jcasallasv/Sistema-de-reconocimiento-de-gestos/DOCUMENTACIÓN/Primera_etapa_Monitoreo_Ambiental/proyecto1embebidos.png

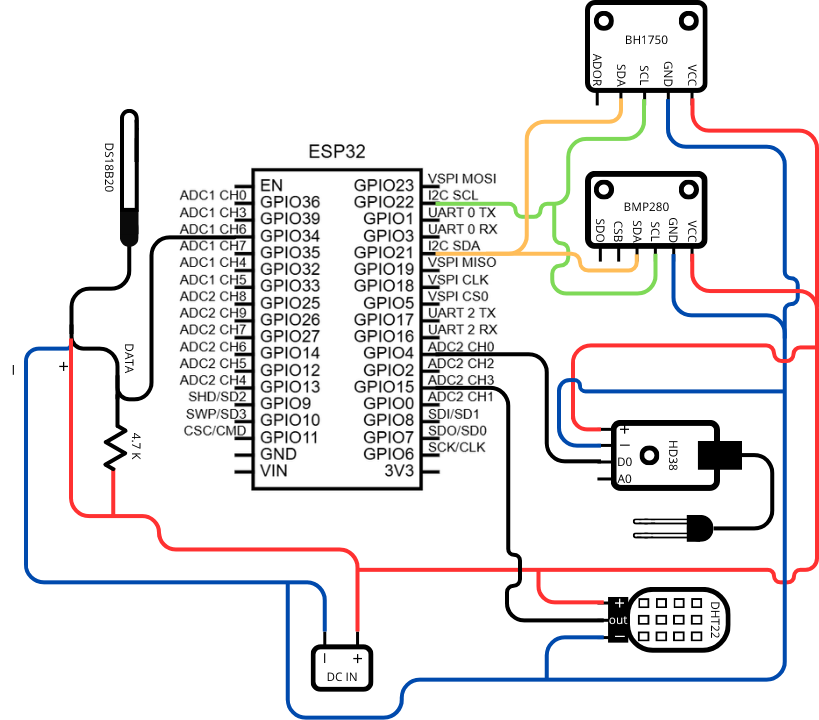
DOCUMENTACIÓN/Primera_etapa_Monitoreo_Ambiental/proyecto1embebidos.png
