jcasallasv/Sistema-de-reconocimiento-de-gestos/Imagenes/esquematico_general.pdf

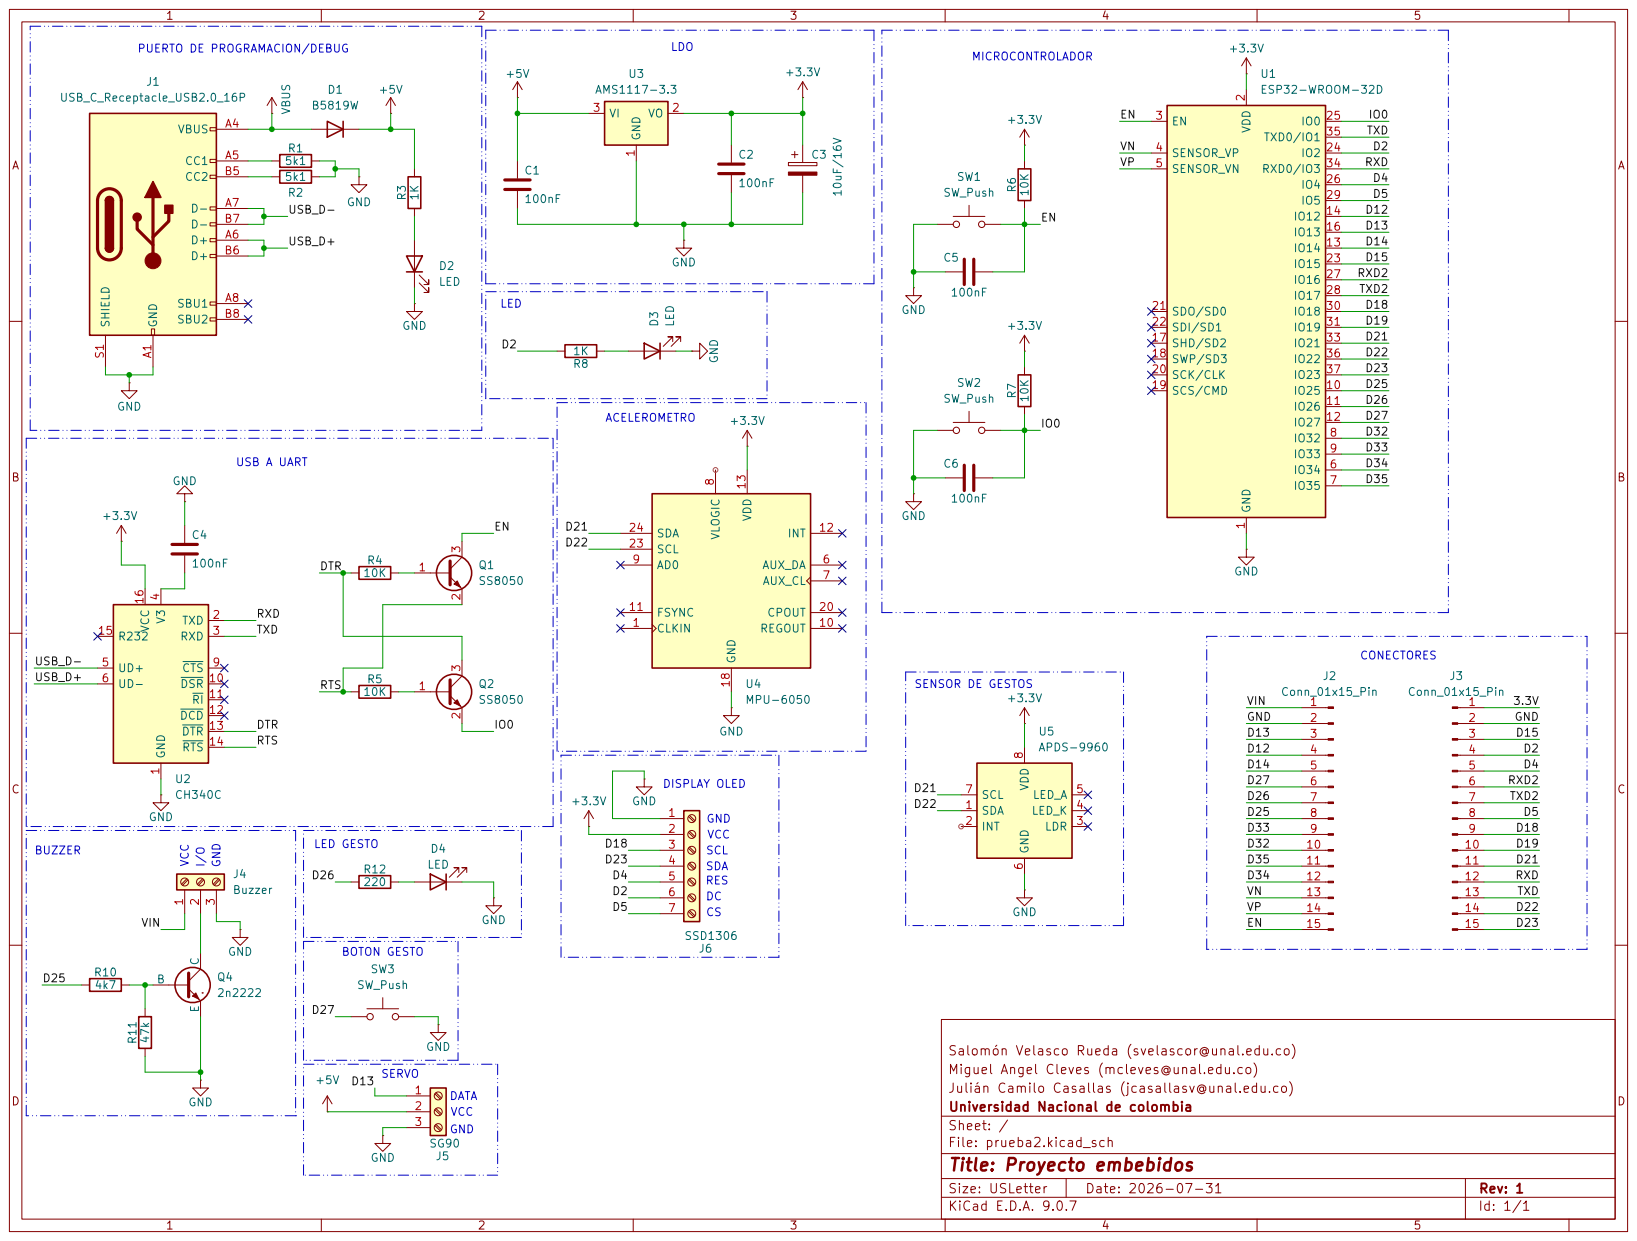
[picture p33: page 1]
