jcasallasv/Sistema-de-reconocimiento-de-gestos/ESP32/led_output_test/led_output_test/led_output_test.ino

constexpr uint8_t LED_PIN = 26;

void setup() {
  Serial.begin(115200);
  delay(1000);

  pinMode(LED_PIN, OUTPUT);
  digitalWrite(LED_PIN, LOW);

  Serial.println();
  Serial.println("LED output test started.");
}

void loop() {
  digitalWrite(LED_PIN, HIGH);
  Serial.println("LED ON");
  delay(1000);

  digitalWrite(LED_PIN, LOW);
  Serial.println("LED OFF");
  delay(1000);
}
