jcasallasv/Sistema-de-reconocimiento-de-gestos/ESP32/mpu6050_i2c_test/mpu6050_i2c_test.ino/mpu6050_i2c_test.ino.ino

#include <Wire.h>

constexpr uint8_t SDA_PIN = 21;
constexpr uint8_t SCL_PIN = 22;

void setup() {
  Serial.begin(115200);
  delay(1000);

  Wire.begin(SDA_PIN, SCL_PIN);

  Serial.println();
  Serial.println("MPU6050 I2C detection test");
  Serial.println("Scanning I2C bus...");

  uint8_t deviceCount = 0;

  for (uint8_t address = 1; address < 127; address++) {
    Wire.beginTransmission(address);
    const uint8_t error = Wire.endTransmission();

    if (error == 0) {
      Serial.print("I2C device found at address 0x");

      if (address < 16) {
        Serial.print("0");
      }

      Serial.println(address, HEX);
      deviceCount++;
    }
  }

  if (deviceCount == 0) {
    Serial.println("No I2C devices found.");
  } else {
    Serial.print("Scan completed. Devices found: ");
    Serial.println(deviceCount);
  }
}

void loop() {
}
