jcasallasv/Sistema-de-reconocimiento-de-gestos/(commit log)

2026-08-01 Agrega ESP32
    [COLLECTOR_CONFIGURATION.txt, SOURCE_COLLECTOR_CONFIGURATION.txt]
2026-08-01 Agrega BUCKUPS
    [COLLECTOR_CONFIGURATION.txt, SOURCE_COLLECTOR_CONFIGURATION.txt]
